mmahdim77/Smart-Home/2پروژه مبانی سیستم های نهفته و بی درنگ.pdf

# پروژه مباین سیسمت های هنفته و یب درنگ

## محمد مهدی معقولی 96243061 علیرضا علیدوستی 96243047

مقدمه: پروژه پیاده سازی شدی، مطابق صورت پروژه یک سیستم مدیریت روشنایی و دمای محیط است که از چند سوییچ محلی و یک

سوییچ مرکزی تشکیل شده. هر کدام از سوییچ های محلی می توانند یک سوییچ 4 پل به همراه 4 led باشند و یا یک گره ترموستات که به کمک سنسور دما ، دما را اندازه گیری می کند و یک دمای مطلوب تعریف شده دارد. در صورت سوال ذکر شده که گره ترموستات به یک گرم کنند متصل باشد و اگر دما از دمای مطلوب کم تر شد، گرم کننده فعال شود. ولی ما به دلیل این که مدار را روی بورد پیاده کردیم و امکان اتصال گرم کننده نداشتیم تغییری در صورت سوال ایجاد کردیم و فرض کردیم که اگر دما از مقدار مطلوب باال تر رفت، خنک کننده )پنکه( فعال شود. گره master می تواند با انتخاب هر کدام از slave ها وضعیت آنها را به صورت local مشاهده کند و در صورت لزوم در آن تغییر ایجاد کند. اگر گره slave یک سوییچ 4 پل باشد وضعیت آن شامل وضعیت روشن یا خاموش بودن led ها می شود که به طور متناظر روی led های گره master نیز وضعیت نمایش داده می شود و می توان هم به کمک کلید های محلی هم به کمک کلید های master آنها را روشن یا خاموش کرد. اگر گره slave، گره ترموستات باشد وضعیت آن شامل دمای اندازه گیری شده و دمای مطلوب می باشد که روی یک نمایشگر در slave نمایش داده می شود و master نیز با انتخاب گره ترموستات وضعیت دما و دمای مطلوبِ slave را روی نمایشگر خود نمایش می دهد. slave ترموستات می تواند با کمک 2 دکمه ای که دارد با هر با فشار دادن آنها دمای مطلوب را یک درجه کاهش یا افزایش دهد. master نیز در هنگام اتصال با دو دکمه می تواند این کار را روی slave انجام دهد. )نکته : در اینجا ما به دلیل محدودیت تعداد پایه روی uno arduino به جای استفاده از نمایشگر در master و گره ترموستات، هر کدام از آنها را به یک ماژول wifi متصل کردیم که به کمک آن وضعیتی که باید رو نمایشگر ها نمایش داده شود را در یک وب سرور ایجاد شده توسط ماژول نمایش می دهیم.اتصال باس بین نود ها به کمک ماژول های 485rs ایجاد شده. همچنین به دلیل محدودیت تعداد بورد های آردوئینو ، برای پیاده سازی یک master و سه slave( دو سوییچ روشنایی و یک گره ترموستات( دو شماره slave به یک بورد آردوئینو تخصیص داده شده که یکی مربوط به سوییچ روشنایی و دیگری مربوط به ترموستات است.
ما از دو ورودی برای انتخاب سوییچ slave استفاده کردیم در نتیجه در نهایت می توانیم 3 slave را متصل کنیم )شماره 0 رزرو است( اما اگر پین های ورودی را بیشتر کنیم و با اضافه کردن ماژول های بیشتر 485max می توان تعداد slave ها را به تعداد دلخواه اضافه کرد

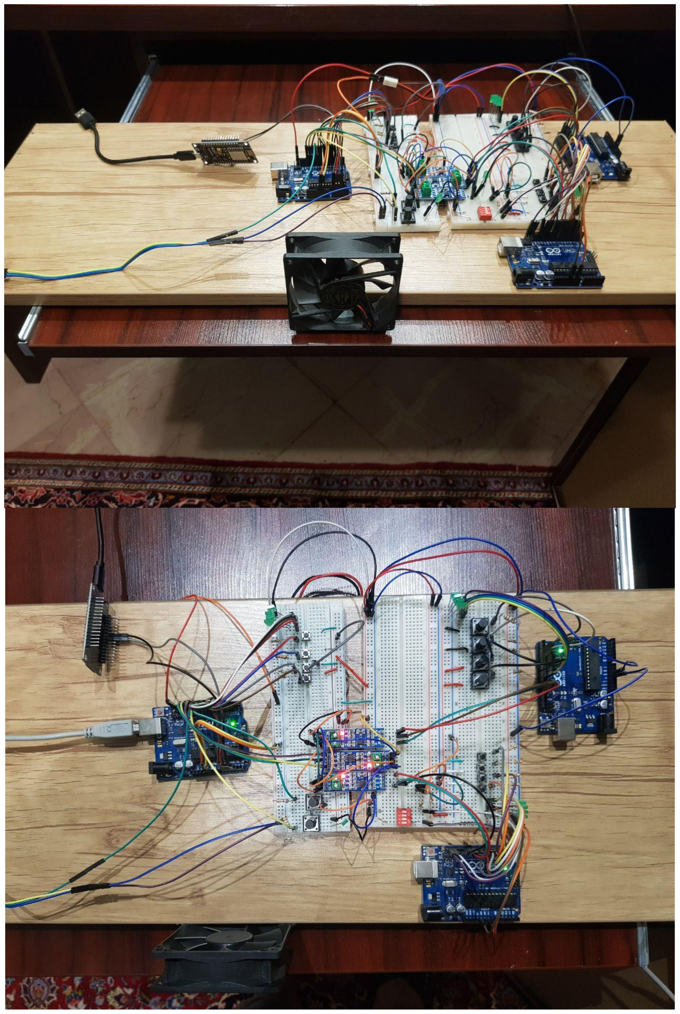
[picture p1: page 3]

## نیازمندی ها

priority | Requirement | ID | parent
1 | 1 تا 4 تا متغیر باشد | | null 1 یک گره master داریم و تعداد slave ها باید تا 3 تا قابل توسعه باشد یعنی تعداد slave ها میتواند از
| | | 1 2 Master در هر لحظه فقط با یک یا هیچکدام از slave ها ارتباط دارد 1
| | | 1 3 با اتنخاب شماره slave از طریق switch dip ، گره master باید با slave مورد نظر sync شود 2
| | | 1 4 Slave میتواند یک سوییچ روشنایی چهار پل یا یک گره ترموستات باشد 1
| | | 4 5 هر گره سوییچ روشنایی دارای چهار پل و چهار led متناظر است 1
| | | 5 6 در هر سوییچ روشنایی هر پل با یک led متناظر است و led با تغییر وضعیت پل روشن یا خاموش میشود 1
| | | 1 7 گره master دارای چهار پل و چهار led متناظر است 1
| | | 7 8 در master هر پل با یک led متناظر است و led با تغییر وضعیت پل روشن یا خاموش میشود 1
1 | master اطالع داده شود و master آن را همانگونه روی led های خود نمایش دهد | | 3 9 Sync شدن masterو slave سوییچ روشنایی به این معنی است که وضعیت led ها در slave به
3 | slave انتخاب شده به master اطالع داده شود. | | 3 10 Sync شدن master با slave گره ترموستات به این معنی است که درجه دما و دمای مطلوب روی
| | | 3 11 ارتباط بین master با slave ها مطابق پروتکل اعالم شده میباشد 1
1 | فقط یک نفر بتواند روی bus بنویسد و همه میتواندد از آن بخوانند | | 11 12 ارتباط master با slave ها بر بستر bus عمومی به صورت halfduplex ایجاد شود یعنی در هر لحظه
2 | روشنایی انتخاب شده، منجر به تغییر وضعیت led ها به طور متناظر در led های master شود | | 9 13 با تغییر وضعیت led ها بوسیله button push مریوط به هرکدام به صورت local در slave سوییچ
2 | led ها به طور متناظر در led های slave سوییچ روشنایی انتخاب شده شود | | 9 14 با تغییر وضعیت led ها بوسیله button push مریوط به هرکدام در master، منجر به تغییر وضعیت
3 | برای آن تعریف میشود | | 4 15 هر گره ترموستات یک سنسور دماسنج دارد که دمای محیط را اندازه گیری میکند و یک مقدار دمای مطلوب
3 | مطلوب را یک درجه کاهش یا یک درجه افزایش داد | | 15 16 به هر گره ترموستات دو button push متصل است که با هر بار کلیک کردن روی آن ها میتوان دمای
| | | 4 17 به هر گره ترموستات یک خنک کننده متصل است 3
| | | 4 18 گره master و گره ترموستات به module، wifi متصل هستند 4
4 | module wifi در هر 1±10.3 میلی ثانیه )با توجه به rate baud و میزان تاخیر 10 ms لحاظ شده در هر بار ارسال سه فریم در هر بار ارسال با توجه به پروتکل ارتباطی) قابل مشاده است | | 10 19 اطالعات دمای اندازه گیری شده و دماب مطلوب روی slaveبر روی webserver ایجاد شده توسط
| | | 17 20 اگر در گره ترموستات دمای اندازه گیری شده بیشتر از دمای مطلوب بود fan روشن شود 3
| | | 1 21 در این پروژه کلید ها با مقاومت down pull پیاده سازی مییشود 2
1 | شود. | | 3 22 با انتخاب یک slave توسط master وضعیت slave، با حداکثر 20 میلی ثانیه تاخیر به master منتقل
| | | 3 23 با تغییر وضعیت روی master، تغییرات با حد اکثر 20 میلی ثانیه تاخیر روی slave اعمال شود 1

تست مدل:

برای انجام تست های الزم از ماژول sequence test استفاده شد که با توجه به ورودی هایی که بوسیله ماژول sequence repeating به فراهم میشود نتیجه نهایی و مورد انتظار بوسیله case test ها مورد ارزیابی قرار میگرد

:Master

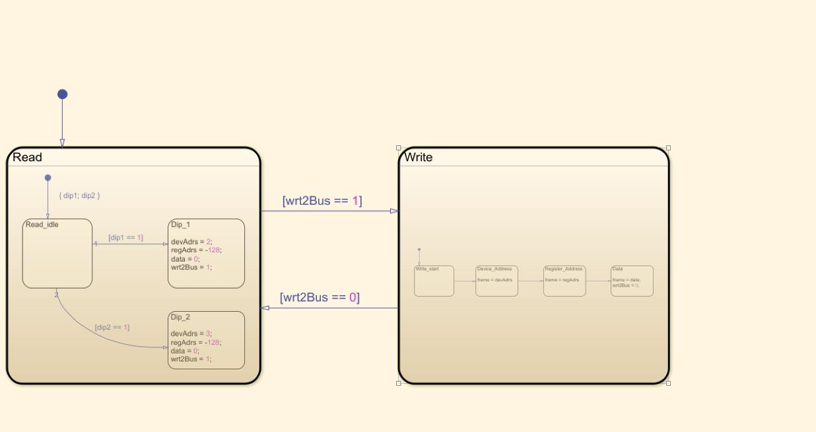
[picture p2: figure]

در کنترلر مربوط به master وروی های ما شامل سوییچ های انتخاب بین دو salve است یعنی 1Dip و 2Dip و خروجی های ما شامل سیگنال های مورد نیاز برای ارتباط بوسیله bus ، Frame، Data، Regard، Devadr، bus2Wrt

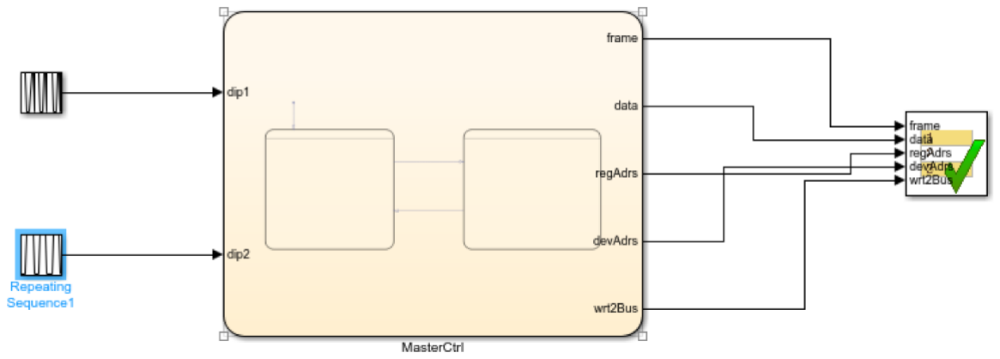
[picture p3: figure]

ورودی ها و تست کیس های ما شامل انتخاب slave یک یا انتخاب slave دو یا هر دو به صورت همزمان است

)که در این حالت به دلیل اولویت در action ها slave با اولویت باالتر انتخاب میشود( یا هیچ کدام میشود

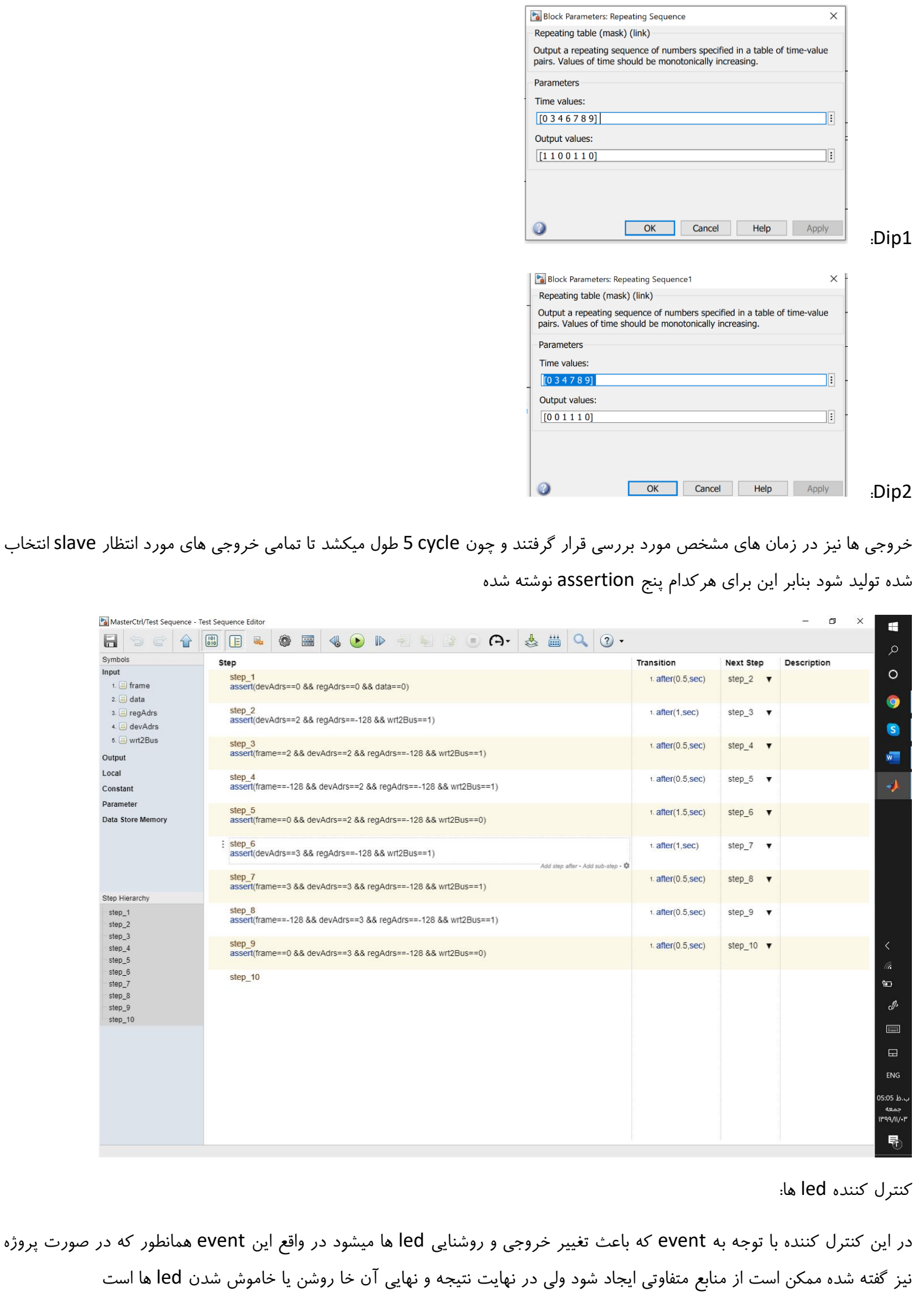
[picture p4: page 6]

:Dip1

:Dip2

خروجی ها نیز در زمان های مشخص مورد بررسی قرار گرفتند و چون cycle 5 طول میکشد تا تمامی خروجی های مورد انتظار slave انتخاب شده تولید شود بنابر این برای هرکدام پنج assertion نوشته شده

کنترل کننده led ها:

در این کنترل کننده با توجه به event که باعث تغییر خروجی و روشنایی led ها میشود در واقع این event همانطور که در صورت پروژه نیز گفته شده ممکن است از منابع متفاوتی ایجاد شود ولی در نهایت نتیجه و نهایی آن خا روشن یا خاموش شدن led ها است

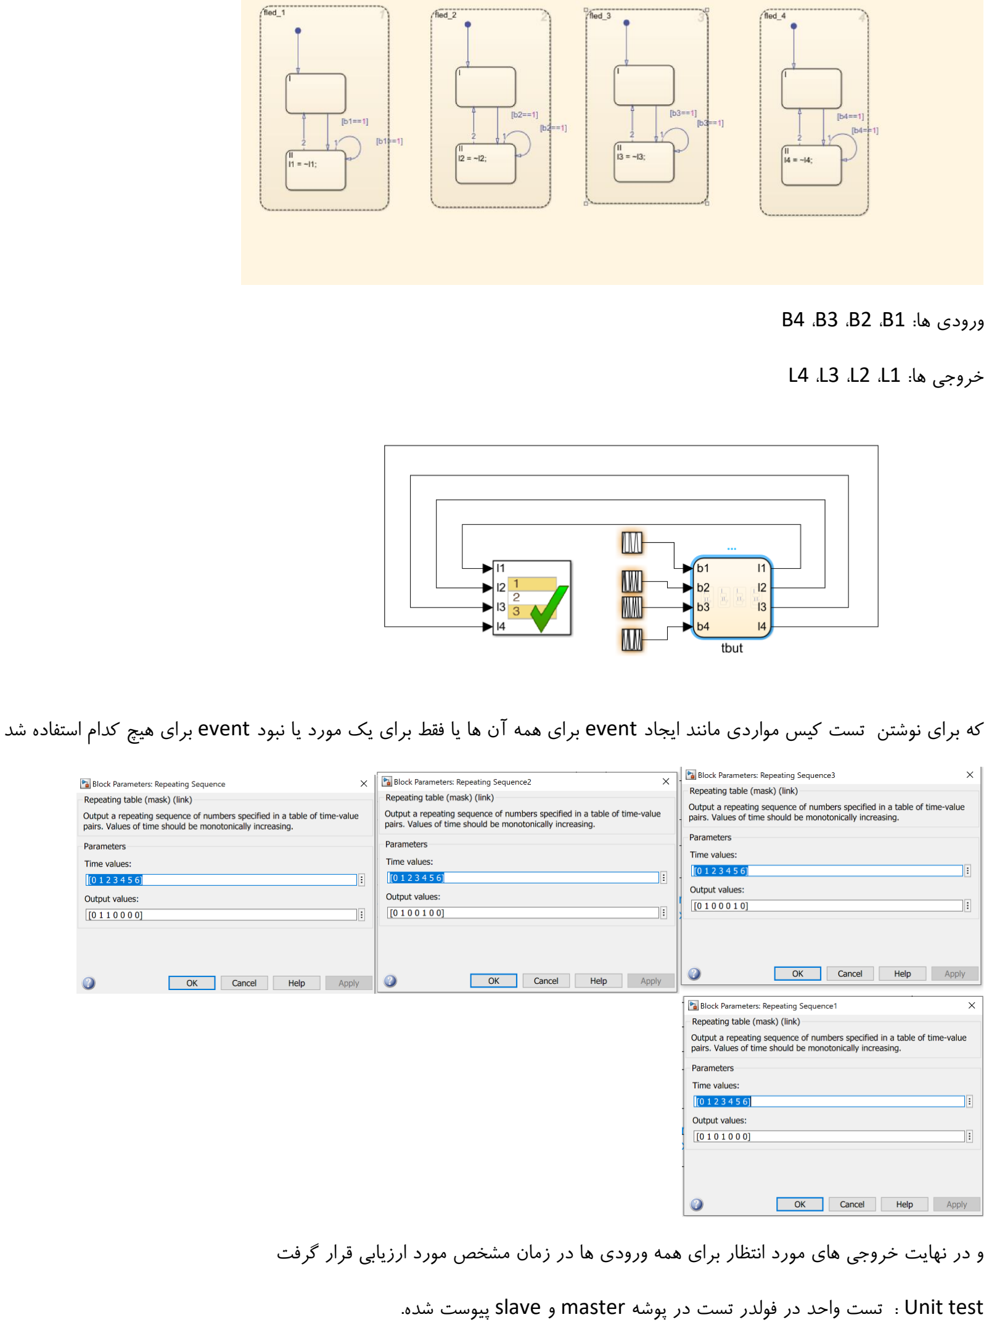
[picture p5: page 7]

B4 ،B3 ،B2 ،B1 :ها | ورودی
L4 ،L3 ،L2 ،L1 :ها | خروجی

که برای نوشتن تست کیس مواردی مانند ایجاد event برای همه آن ها یا فقط برای یک مورد یا نبود event برای هیچ کدام استفاده شد

و در نهایت خروجی های مورد انتظار برای همه ورودی ها در زمان مشخص مورد ارزیابی قرار گرفت

test Unit : تست واحد در فولدر تست در پوشه master و slave پیوست شده.

تست عملکرد blackbox : برای انجام این تست برای هر کدام از نیازمندی ها که امکان داشت یک تست box black طراحی کردیم و آن را روی بورد پیاده کرده و صحت عملکرد آن را بررسی کردیم. تست ها و نتایج به شرح زیر هستند:

توضیحات | P/F | test | Req id | id
ترتیب اضافه شد و صحت عملکرد master در اتصال به هر 3 slave و مشاهده وضعیت آنها ممکن بود | pass پیاده سازی انجام شد و slave ها به | پیاده سازی برای slave با شماره id های 1 2 و 3 ایجاد شود و صحت عملکرد و ارتباطات بررسی شود | | 1 1 یک گره master ایجاد شود و دو آردوئینو هر کدام با دو
| pass | و هر بار تنها وضعیت یکی را عیناً ببینیم و با تغییر وضعیت در master تنها وضعیت slave انتخاب شده تغییر کند | | 2 2 و 14 هر بار با switch deep یکی از slave ها را انتخاب کنیم
| Pass | را عینا در master مشاهده کنیم | | 3 3 از Master یک slave را انتخاب کنیم و وضعیت slave
| pass | switch روشنایی | | 4 4 همزمان هم گره ترموستات در مدار داشته باشیم هم
| Pass | چراغ تغییر وضعیت دهد | | 5 6 و 8 در هر سوییچ با کلیک بر روی هر button push تنها یک
| Pass | و هر بار تنها وضعیت یکی را عیناً ببینیم و با تغییر وضعیت در slave، وضعیت در master نیز تغییر کند | | 6 13 هر بار با switch deep یکی از slave ها را انتخاب کنیم
| Pass | دمای مطلوب را روی نمایشگر هر دو گره مشاهده کنیم | | 7 10 در master یک گره ترموستات را انتخاب کنیم و دما و
| Pass | اعمال می شود | | 8 16 دکمه ها را فشار دهیم و مشاهده کنیم که در نمایشگر تغییر
| Pass | مشاهده کنیم که وضعیت گره ترموستات در وب سرویس قابل مشاهده است و تغییرات اعمال می شوند | 19 | 9 18 و
| Pass | اندازه گیری شده بیشتر شود و پنکه وصل شود | | 10 20 دمای ترشولد را به کمک دکمه ها پایین بیاوریم تا دمای
| pass | گیری شده کم تر شود و پنکه قطع شود | | 11 21 دمای ترشولد را به کمک دکمه ها باال ببریم تا دمای اندازه

تست های whitebox:

توضیحات | P/F | test | Req id | id
| pass | ازای هر دکمه( | | 1 21 با فشار دادن دکمه ها، پین متصل به آن مقدار 1 منطقی بگیرد )به
| pass | در هر جا که می خواهیم مقادیر را روی سریال بنویسیم، با هر بار نوشتن مقدار را روی پورت سریال چاپ کنیم، و هر جا که می خوانیم نیز مقدار خوانده شده را چاپ کنیم. هردو را در پنجره serial | 12 | 2 11و

| monitor زیر نظر بگیریم که زمانی که باید مقادیری نوشته شود سه فریم مطابق پروتکل نوشته شود و سپس همان 3 فریم مطابق پروتکل خوانده شود )هر جا که خواندن و نوشتن داریم(
نتوانستیم بررسی دقیق کنیم ولی با فشار دادن دکمه ها به صورت دستی این اتفاق نمی افتاد یا سیستم fail نمی شد. | master فشار می دهیم. نباید بتوانند همزمان باس را در اختیار بگیرند ) کنترل را 1 کنند( | 3 11 همزمان دو دکمه را یکی در slave انتخاب شده و دیگری را در

پیاده سازی و چالش های پروژه:

برای پیاده سازی پروژه از uno Arduino برای هر کدام از سوییچ ها استفاده کردیم ، برای ارتباط بین 3 آردوئینو از ماژول 485max استفاده شد. برای هر کدام از سوییچ ها 4 led به همراه 4 button pushدر نظر گرفتیم که pushbutton ها به صورت down pull بسته شدند. برای انتخاب سوییچ در مستر از دیپ سوییچ استفاده شد. از 11DHT به عنوان سنسور دما استفاده کردیم و برای نمایش دیتای دما از ماژول وایفای 3v NodeMCU استفاده شد. به دلیل محدودیت در تعداد آردوئینو ها )3 آردوئینو در اختیار داشتیم( برای پیاده سازی 2 سوییچ 4 پل و یک گره ترموستات و یک master ، یکی از آردوئینو ها را هم به یک گره ترموستات و هم به یک سوییچ 4 پل اختصاص دادیم. نحوه کار این ماژول به این صورت است که اگر master، slave شماره 2 را صدا زد کد مربوط به سوییچ اجرا می شود و اگر شماره 3 را صدا زد، کد گره ترموستات اجرا می شود. یک آردوئینو هم به طور اختصاصی slave switch است و روی شماره 1 صدا زده می شود. و یک آردوئینو هم نود master را میزبانی می کند.

ابتدا نیازمندی ها را مشخص کردیم و برای فرآیند ها diagram sequence رسم کردیم.

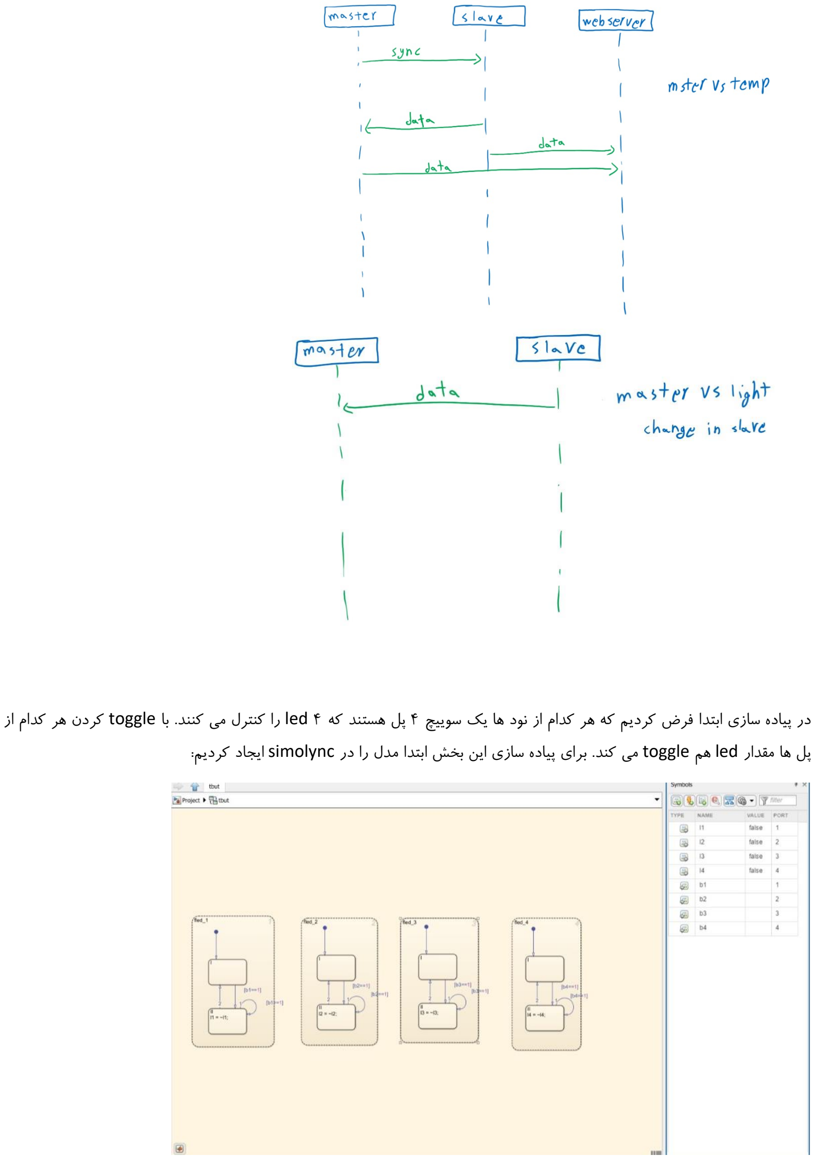
[picture p6: page 10]

در پیاده سازی ابتدا فرض کردیم که هر کدام از نود ها یک سوییچ 4 پل هستند که 4 led را کنترل می کنند. با toggle کردن هر کدام از پل ها مقدار led هم toggle می کند. برای پیاده سازی این بخش ابتدا مدل را در simolync ایجاد کردیم:

در این مدل به صورت موازی برای هر کدام از پایه ها که سیگنال bx( button )فعال شد، وارد استیت toggle می شویم و المپ را روشن یا خاموش می کند و دوباره به استیت idle بر می گردد.

سپس خروجی کد گرفتیم و بر روی خروجی پیاده سازی مربوط به آردوئینو را انجام دادیم و نتیجه به دست آمد .

در مرحله بعد باید ارتباط بین نود ها را برقرا می کردیم. برای این کار ابتدا مدل را پیاده سازی کردیم:

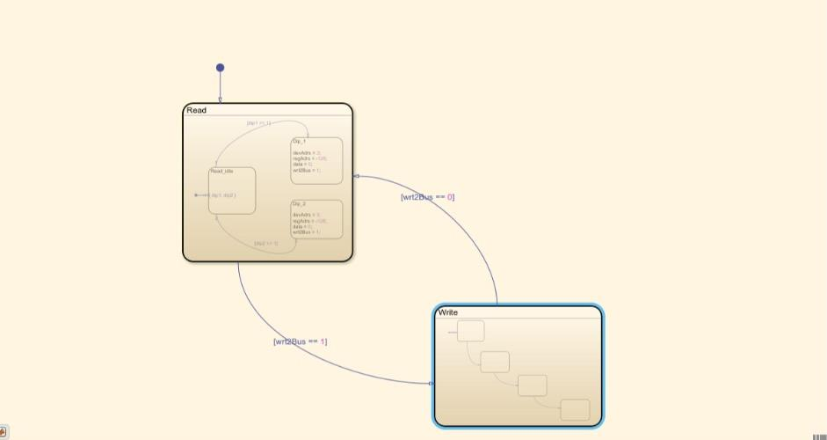
[picture p7: figure]
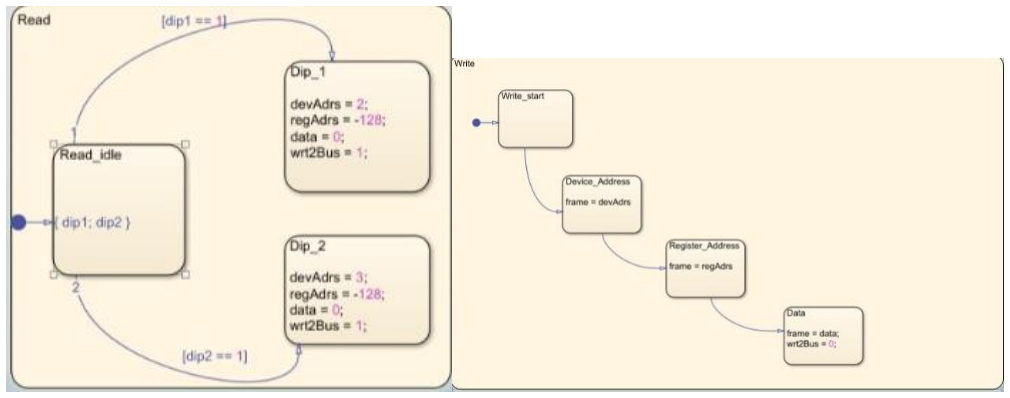
[picture p8: figure]

سپس کد را استخراج کردیم و سعی کردیم پیاده سازی را انجام دهیم .برای پیاده سازی این بخش به کمک مدل ایجاد شده و مطابق پروتکل تعیین شده با ایجاد تغییراتی در کد پیاده سازی را انجام دادیم. این مدل را ابتدا برای اتصال دو نود ایجاد کردیم. سپس کد را به گونه ای تغییر دادیم که با انتخاب شماره دیوایس به کمک دیپ سوییچ، مقدار فریم اول تغییر کند و بتوان روی هر slave با چک کردن فریم اول متوجه شد که دیتا برای کدام فریم است. در نتیجه مدل توسعه پذیر شد و حال می توانیم تعداد slave ها را زیاد کنیم. و در نهایت کارکرد ها را ایجاد کردیم.

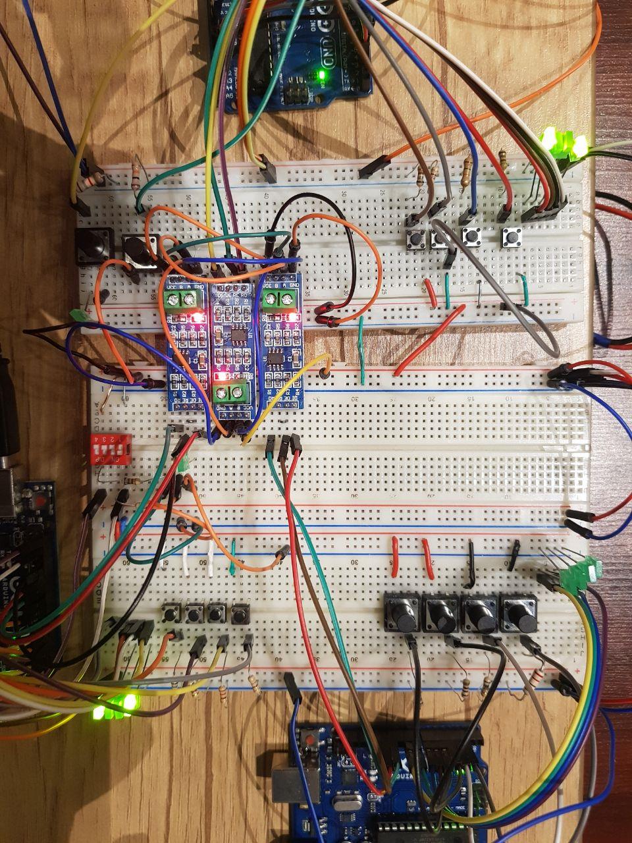
[picture p9: page 12]
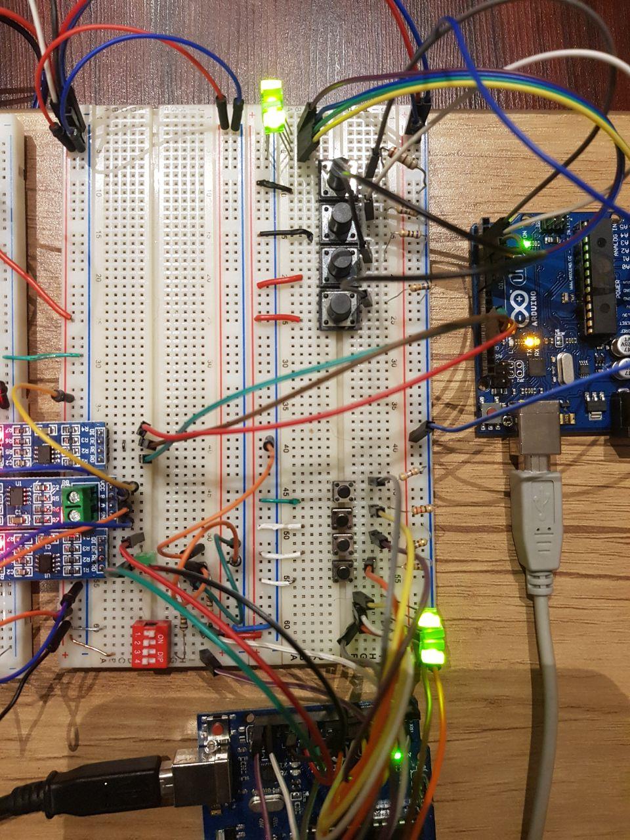
[picture p10: page 13]
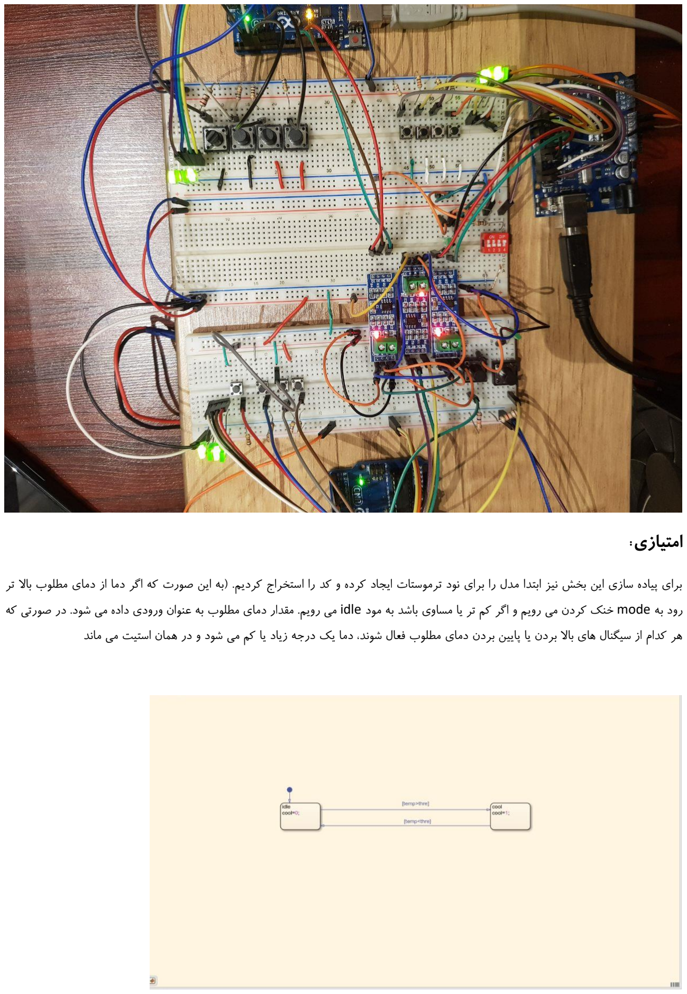
[picture p11: page 14]

## امتیازی:

برای پیاده سازی این بخش نیز ابتدا مدل را برای نود ترموستات ایجاد کرده و کد را استخراج کردیم. )به این صورت که اگر دما از دمای مطلوب باال تر رود به mode خنک کردن می رویم و اگر کم تر یا مساوی باشد به مود idle می رویم. مقدار دمای مطلوب به عنوان ورودی داده می شود. در صورتی که هر کدام از سیگنال های باال بردن یا پایین بردن دمای مطلوب فعال شوند، دما یک درجه زیاد یا کم می شود و در همان استیت می ماند

بعد از این که از عملکرد دماسنج، کلید ها ، پنکه و در نهایت تمام نود اطمینان حاصل شد، ارتباط با masterرا شکل دادیم به این صورت که با انتخاب slave توسط مستر در دو مرتبه هر بار در 3 فریم طبق پروتکل داده دمای اندازه گیری شده و دمای مطلوب برای master ارسال می شود. برای نمایش این داده ها در هر دو طرف به جای نمایش روی lcd از ماژول wifi و استفاده از وبسرویس آن استفاده شده.

برای اتصال ماژول وای فای ابتدا تنظیمات کانفیگ آن را انجام دادیم و از طریق دو پورت سریال داده ها از نود ها برای آن ارسال می شود و ماژول آن را روی وب سرور نمایش می دهد. همچنین می توان عملکرد دکمه ها را نیز به این ماژول منتقل کرد.

چالش ها:

یکی از چالش ها اجرای همزمان دیباگ کردن به وسیله monitor serial و استفاده از پورت های سریال برای ارتباط با دیگر نود ها بود )به دلیل کم بودن پورت های سریال روی uno Arduino). برای حل این چالش ، از کتابخانه softwareserial استفاده کردیم که دو پین دیجیتال را به پین سریال تبدیل می کند )شبیه سازی می کند( و از آن برای ارتباط بین نود ها استفاده کردیم.

چالش بعدی مشکل کم بودن تعداد پین ها روی uno Arduino بود. مشکل مخصوصا زمانی نمود پیدا می کرد که می خواستیم روی یک آردوئینو هم 4 led هم 4 دکمه و هم پایه های lcd را متصل کنیم . برای حل مشکل کمبود پین دیجیتال از پین های آنالوگ هم استفاده کردیم. این امکان روی آردوئینو وجود داشت که از پین های آنالوگ هم مقدار دیجیتال بخوانیم یا بنویسیم. از ان پین ها برای روشن کردن چراغ ها استفاده شد. همنچنین برای حل مشکل تعداد باالی پایه های lcd، تصمیم گرفتیم که یک ماژول وای فای را به master و گره ترموستات متصل کنیم که بتوانیم داده روی هر دو گره را روی وب سرور ایجاد شده توسط این ماژول مشاهده کنیم.

چالش دیگر پروژه ایجاد دو پورت سریال بر روی یک آردوئینو بود ) یکی برای ارتباط بین نود ها و دیگری برای ارتباط با ماژول وایفای(. زیرا به طور همزمان نمی شود دو نمونه از serial software داشت. برای حل این مشکل پورت سریال آردوئینو را به ارتباط با وایفای اختصاص دادیم و از تابع ()listen. برای تعیین پورت هایی که بایدlisten کنند استفاده کردیم.

برای ایجاد ارتباط بین ماژول ها به کمک باس سریال مطابق پروتکل در هر بار نوشتن برای هر کنترلری که می خواهد بنویسد پین کنترل را 1 می کنیم و 3 مقدار را روی سریال می نویسیم. سپس پین کنترل را 0 می کنیم )کنترل 1 برای نوشتن و 0 برای خواندن(. و برای خواندن هر زمان که روی باس مقدار وجود داشت، 3 فریم می خوانیم، اگر 3 فریم خوانده شده بود فریم ها را بررسی می کنیم و بر حسب مورد عملکرد متناظر را انجام می دهیم.
