mmahdim77/Smart-Home/(list of files, drawings)

Other design files:
proteus.pdsprj
