mmahdim77/Smart-Home/MasterAtmega/include/rtwtypes.h

//
// File: rtwtypes.h
//
// Code generated for Simulink model 'Floor0'.
//
// Model version                  : 1.28
// Simulink Coder version         : 9.1 (R2019a) 23-Nov-2018
// C/C++ source code generated on : Fri Jan 24 16:51:36 2020
//
// Target selection: ert.tlc
// Embedded hardware selection: Atmel->AVR
// Code generation objectives:
//    1. Execution efficiency
//    2. RAM efficiency
// Validation result: Not run
//

#ifndef RTWTYPES_H
#define RTWTYPES_H

// Logical type definitions
#if (!defined(__cplusplus))
#  ifndef false
#   define false                       (0U)
#  endif

#  ifndef true
#   define true                        (1U)
#  endif
#endif

//=======================================================================*
//  Target hardware information
//    Device type: Atmel->AVR
//    Number of bits:     char:   8    short:   16    int:  16
//                        long:  32    long long:  64
//                        native word size:   8
//    Byte ordering: LittleEndian
//    Signed integer division rounds to: Zero
//    Shift right on a signed integer as arithmetic shift: on
// =======================================================================

//=======================================================================*
//  Fixed width word size data types:                                     *
//    int8_T, int16_T, int32_T     - signed 8, 16, or 32 bit integers     *
//    uint8_T, uint16_T, uint32_T  - unsigned 8, 16, or 32 bit integers   *
// =======================================================================
typedef signed char int8_T;
typedef unsigned char uint8_T;
typedef int int16_T;
typedef unsigned int uint16_T;
typedef long int32_T;
typedef unsigned long uint32_T;
typedef long long int64_T;
typedef unsigned long long uint64_T;

//===========================================================================*
//  Generic type definitions: boolean_T, char_T, byte_T, int_T, uint_T,       *
//                            ulong_T, ulonglong_T.                           *
// ===========================================================================
typedef unsigned char boolean_T;
typedef int int_T;
typedef unsigned int uint_T;
typedef unsigned long ulong_T;
typedef unsigned long long ulonglong_T;
typedef char char_T;
typedef unsigned char uchar_T;
typedef char_T byte_T;

//=======================================================================*
//  Min and Max:                                                          *
//    int8_T, int16_T, int32_T     - signed 8, 16, or 32 bit integers     *
//    uint8_T, uint16_T, uint32_T  - unsigned 8, 16, or 32 bit integers   *
// =======================================================================
#define MAX_int8_T                     ((int8_T)(127))
#define MIN_int8_T                     ((int8_T)(-128))
#define MAX_uint8_T                    ((uint8_T)(255U))
#define MAX_int16_T                    ((int16_T)(32767))
#define MIN_int16_T                    ((int16_T)(-32768))
#define MAX_uint16_T                   ((uint16_T)(65535U))
#define MAX_int32_T                    ((int32_T)(2147483647L))
#define MIN_int32_T                    ((int32_T)(-2147483647L-1L))
#define MAX_uint32_T                   ((uint32_T)(0xFFFFFFFFUL))
#define MAX_int64_T                    ((int64_T)(9223372036854775807LL))
#define MIN_int64_T                    ((int64_T)(-9223372036854775807LL-1LL))
#define MAX_uint64_T                   ((uint64_T)(0xFFFFFFFFFFFFFFFFULL))

// Block D-Work pointer type
typedef void * pointer_T;

#endif                                 // RTWTYPES_H

//
// File trailer for generated code.
//
// [EOF]
//
